d4vvv/MPT2-Project---LEDCUBE/Documentation/Led_cube_bottom.pdf

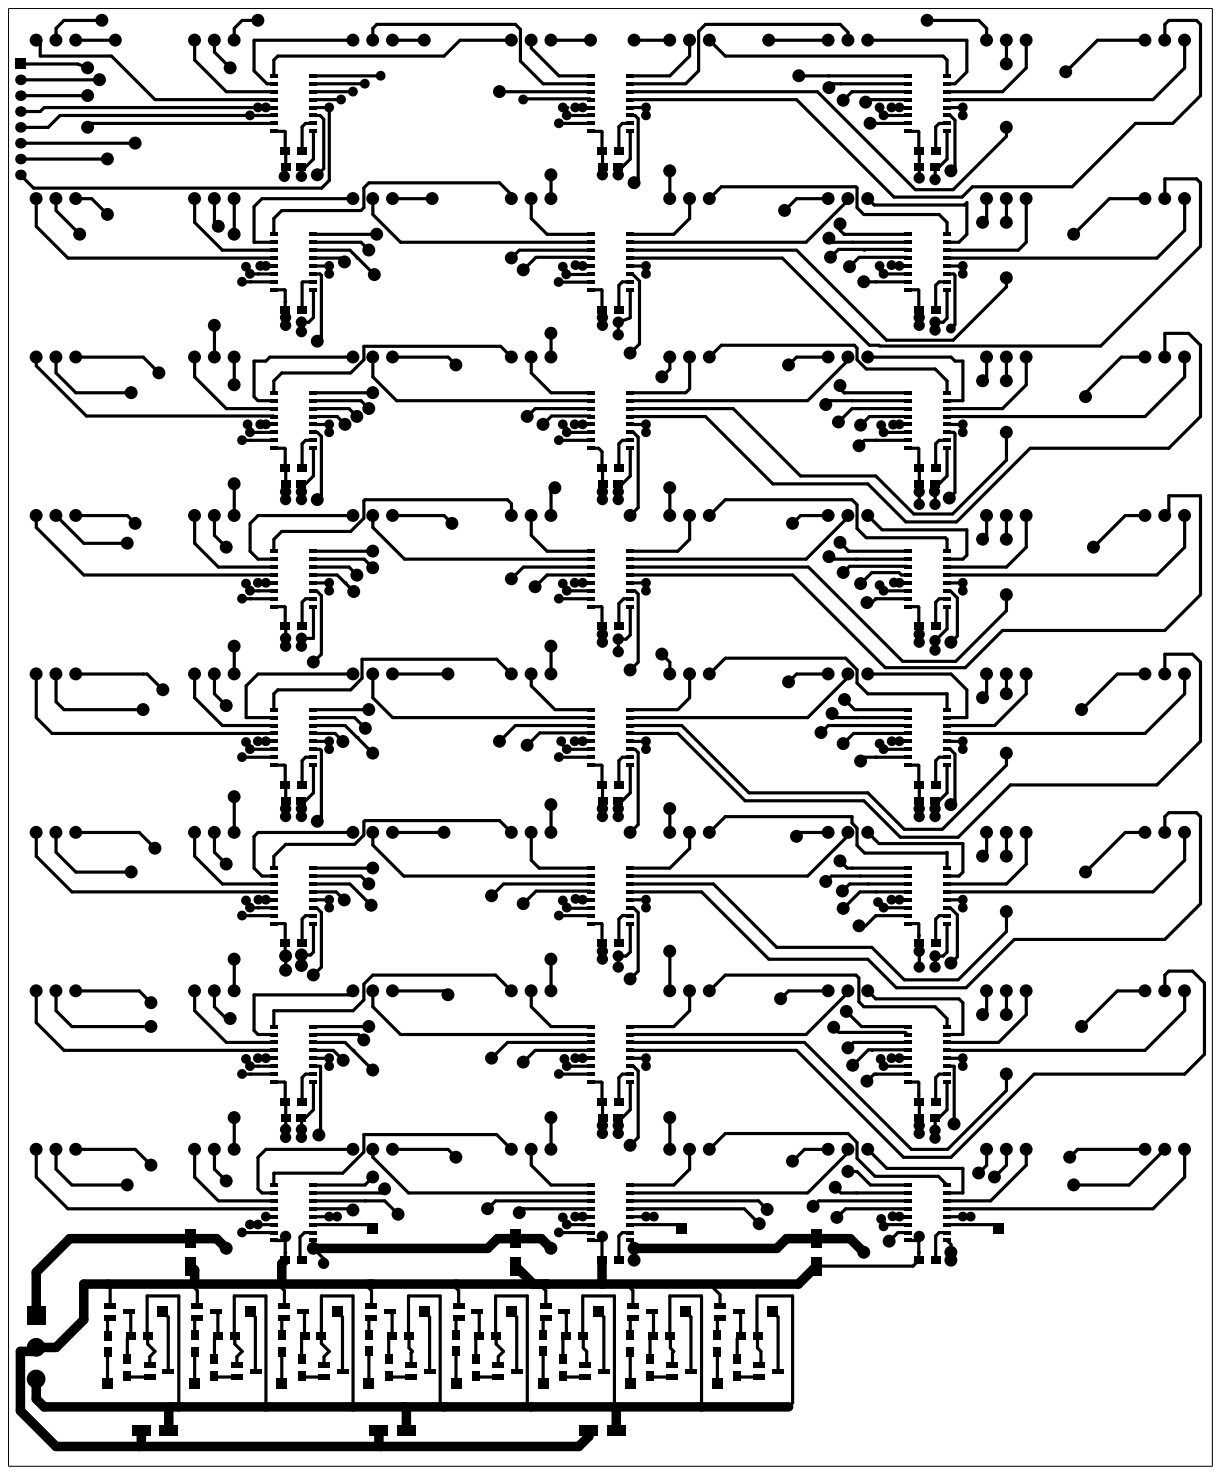
[picture p12: page 1]
