d4vvv/MPT2-Project---LEDCUBE/Code/tpm.h

/******************************************************************************
 * This file is a part of the SM2 Tutorial (C).                               *                                                 *
 ******************************************************************************/

/**
 * @file tpm.h
 * @author Koryciak
 * @date Nov 2020
 * @brief File containing enums, structures and declarations for TPM.
 * @ver 0.1
 */

#ifndef TPM_H
#define TPM_H

/**
 * @brief TPM1 initialization. Input capture.
 */
void TPM0_Init_PWM(void);

#endif /* TPM_H */
