d4vvv/MPT2-Project---LEDCUBE/Code/uart0.h

#include "MKL05Z4.h"
//----------------------------------------------
// SIM_SOPT2
//----------------------------------------------
// Source clock
//
#define CLK_DIS 					0x00
#define MCGFLLCLK 				0x01
#define OSCERCLK					0x02
#define MCGIRCLK					0x03

void UART0_Init(void);
